nseidle/Money_Vacuum/Images/SSR Inside Housing.jpg

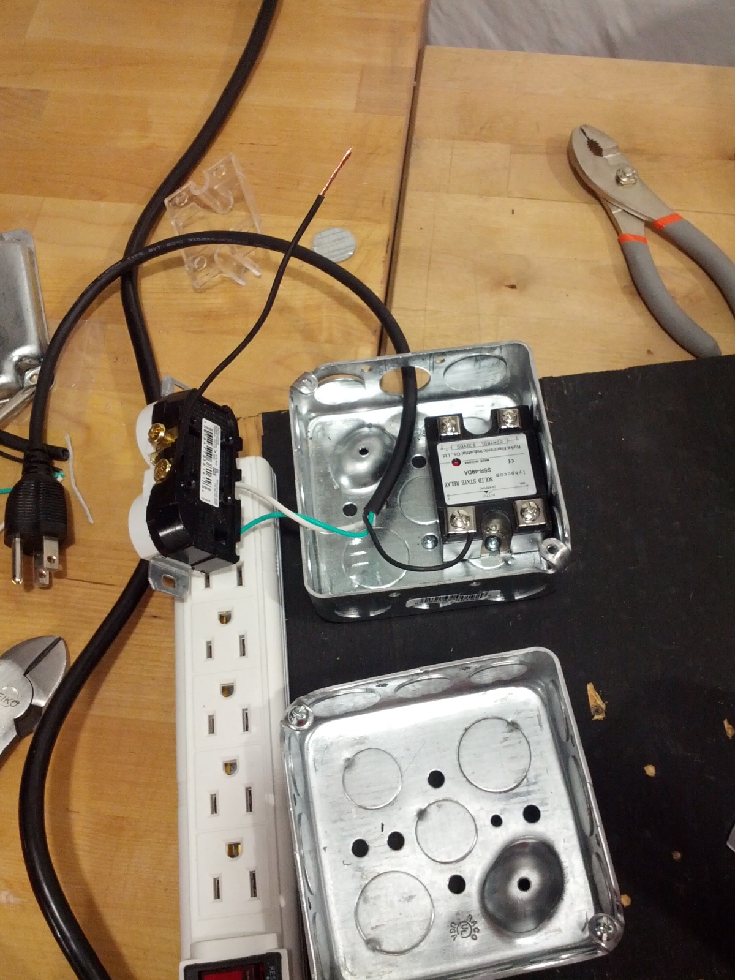
Images/SSR Inside Housing.jpg
