nseidle/Money_Vacuum/Master Plan/MoneyVacuum-MasterPlan.pdf

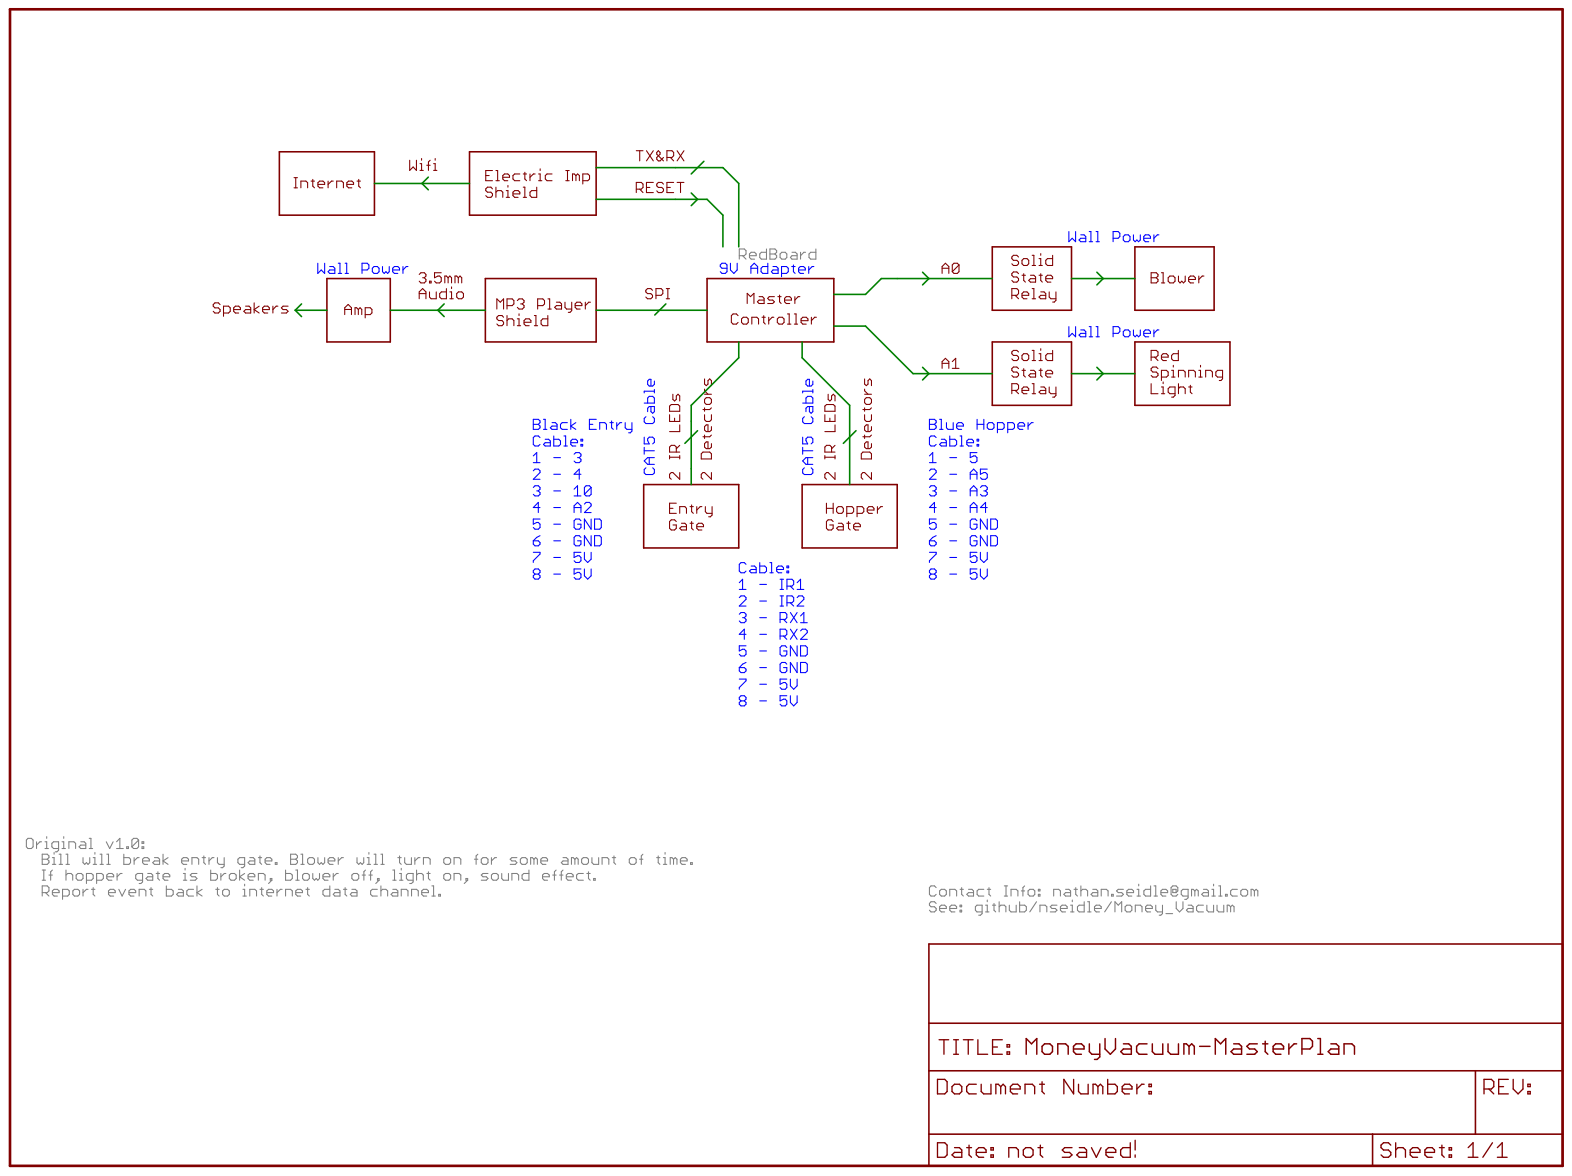
[picture p9: page 1]
