nseidle/Money_Vacuum/(commit log)

2014-08-18 Correctly reads override switch. Added Watchdog checking.
    This is production code and has been running for about two months
    successfully.
    [Money_Vacuum.ino]
2014-08-18 Adding Imp Agent and Device. Increase volume.
    You can't hear the pirate tracks on a busy day.
2015-01-22 More volume adjustments.
    Volume doesn't seem to work from software when using an external amp.
    Setting to reasonably low volume and turning up the amp.
    [Money_Vacuum.ino]
2016-02-17 Added pdf of master plan schematic
2022-05-17 Add support for silent MP3 to avoid buzzing
    [Money_Vacuum.ino, Sounds.ino]
